jelgerlemmens/ToyTrainESP32/schematic.pdf

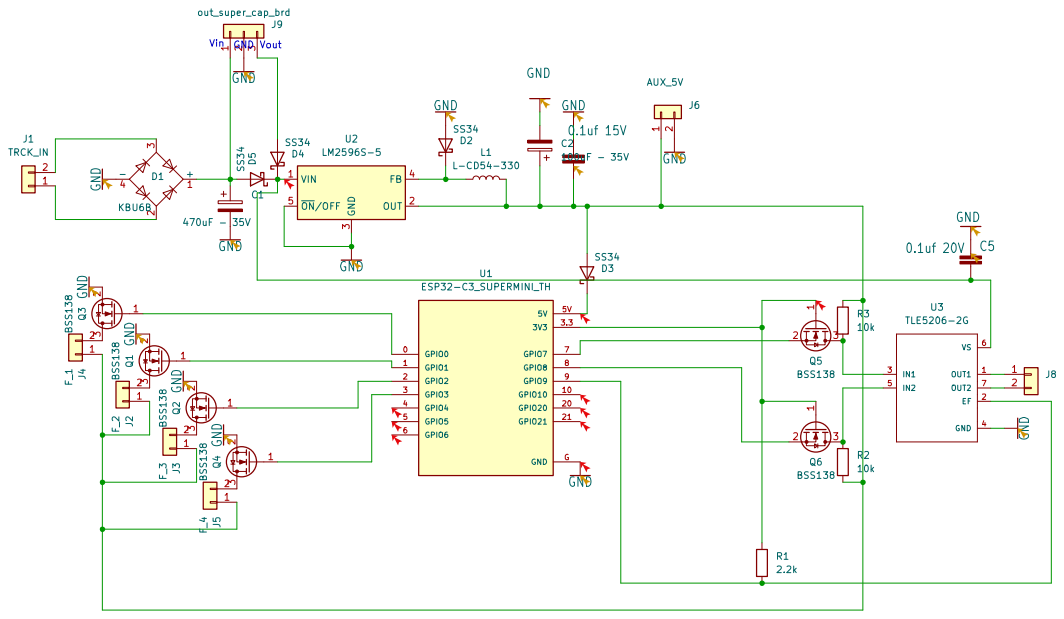
[picture p1: page 1]
