jelgerlemmens/ToyTrainESP32/kicad/decoder_esp32_rev1/decoder_esp32_rev1.kicad_pcb

## KiCad design kicad/decoder_esp32_rev1/decoder_esp32_rev1.kicad_pcb (2026-06-09)

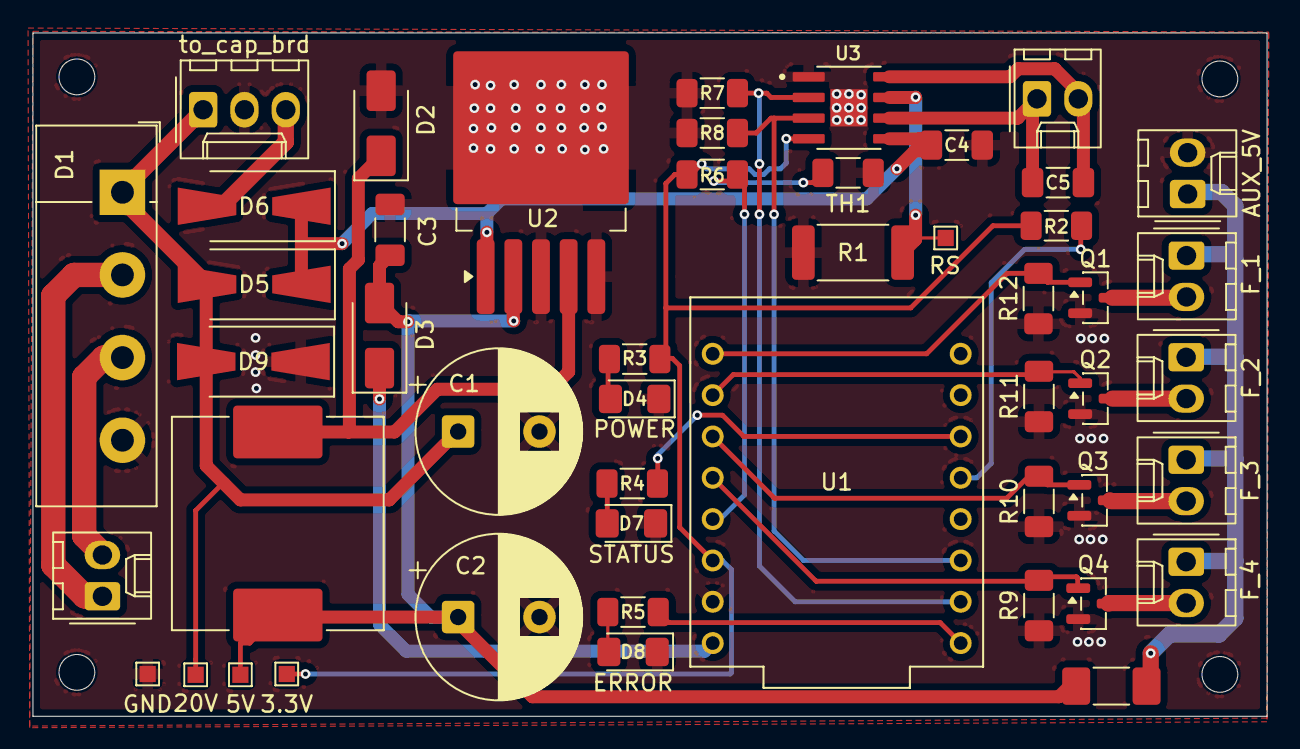
[picture p2: board decoder_esp32_rev1.kicad_pcb from above]

Board: 2 copper layers, 75.9 x 42.0 mm, 49 parts (0 on the bottom side), 31 nets.

Parts:
C1: CP_Radial_D10.0mm_P5.00mm
C2: 470uF - 35V; CP_Radial_D10.0mm_P5.00mm
C3, C4, C5: 0.1uF; C_1206_3216Metric_Pad1.33x1.80mm_HandSolder
D1: KBU6B; Diode_Bridge_Vishay_KBU
D2, D3: SS34; D_SMA
D4: POWER; D_1206_3216Metric_Pad1.42x1.75mm_HandSolder
D5, D6: S5M; D_SMA-SMB_Universal_Handsoldering
D7: STATUS; D_1206_3216Metric_Pad1.42x1.75mm_HandSolder
D8: ERROR; D_1206_3216Metric_Pad1.42x1.75mm_HandSolder
D9: smbj24a; D_SMA-SMB_Universal_Handsoldering
F1: Fuse; C_1808_4520Metric_Pad1.72x2.30mm_HandSolder
J1: TRCK_IN; Molex_KK-254_AE-6410-02A_1x02_P2.54mm_Vertical
J2: F_2; Molex_KK-254_AE-6410-02A_1x02_P2.54mm_Vertical
J3: F_3; Molex_KK-254_AE-6410-02A_1x02_P2.54mm_Vertical
J4: F_1; Molex_KK-254_AE-6410-02A_1x02_P2.54mm_Vertical
J5: F_4; Molex_KK-254_AE-6410-02A_1x02_P2.54mm_Vertical
J6: AUX_5V; Molex_KK-254_AE-6410-02A_1x02_P2.54mm_Vertical
J8: MTR_OUT; Molex_KK-254_AE-6410-02A_1x02_P2.54mm_Vertical
J9: to_cap_brd; Molex_KK-254_AE-6410-03A_1x03_P2.54mm_Vertical
L1: 68uH; L_Changjiang_FXL1340
Q1, Q2, Q3, Q4: BSS138; SOT-23
R1: 0.15 Ohm; R_2512_6332Metric_Pad1.40x3.35mm_HandSolder
R2: 2.2K; R_1206_3216Metric_Pad1.30x1.75mm_HandSolder
R3: GRN 100Ohm; R_1206_3216Metric_Pad1.30x1.75mm_HandSolder
R4: Yellow Status 150Ohm; R_1206_3216Metric_Pad1.30x1.75mm_HandSolder
R5: Red ERROR 150Ohm; R_1206_3216Metric_Pad1.30x1.75mm_HandSolder
R6: 10k; R_1206_3216Metric_Pad1.30x1.75mm_HandSolder
R7, R8, R9, R10, R11, R12: 10K pulldown; R_1206_3216Metric_Pad1.30x1.75mm_HandSolder
TH1: Thermistor_NTC; R_1206_3216Metric_Pad1.30x1.75mm_HandSolder
TP1: GND; TestPoint_Pad_1.0x1.0mm
TP2: 20V; TestPoint_Pad_1.0x1.0mm
TP3: 5V; TestPoint_Pad_1.0x1.0mm
TP4: 3.3V; TestPoint_Pad_1.0x1.0mm
TP5: RS; TestPoint_Pad_1.0x1.0mm
U1: ESP32-C3_SUPERMINI_TH; MODULE_ESP32-C3_SUPERMINI_TH
U2: LM2596S-5; TO-263-5_TabPin3
U3: TB67H450FNG_EL; SOIC127P599X175-9N

Connections:
GND: C1.2, C2.2, C3.1, C4.1, D1.4 (-), D2.2 (A), D4.1 (K), D7.1 (K), D8.1 (K), D9.1 (K), J6.2, J9.2, Q1.2 (S), Q2.2 (S), Q3.2 (S), Q4.2 (S), R1.2, R7.1, R8.2, R9.1, R10.1, R11.1, R12.1, TH1.2, TP1.1 (1_1), U1.G (GND), U2.3 (GND), U2.5 (~ON/OFF), U3.1 (GND), U3.9 (GND)
unnamed: C1.1, D1.1 (+), D5.2 (A), D9.2 (A), J9.1, TP2.1 (1_1)
unnamed: D2.1 (K), L1.1, U2.4 (FB)
unnamed: C2.1, C3.2, D3.2 (A), F1.1, L1.2, TP3.1 (1_1), U2.2 (OUT)
unnamed: D3.1 (K), U1.5V
unnamed: D4.2 (A), R3.2
unnamed: C4.2, D5.1 (K), D6.1 (K), U2.1 (VIN), U3.5 (VM)
unnamed: D6.2 (A), J9.3
unnamed: D7.2 (A), R4.2
unnamed: D8.2 (A), R5.2
unnamed: D1.2, J1.1
unnamed: D1.3, J1.2
unnamed: F1.2, J2.1, J3.1, J4.1, J5.1, J6.1
unnamed: J2.2, Q2.3 (D)
unnamed: J3.2, Q3.3 (D)
unnamed: J4.2, Q1.3 (D)
unnamed: J5.2, Q4.3 (D)
unnamed: C5.1, J8.1, U3.6 (OUT1)
unnamed: C5.2, J8.2, U3.8 (OUT2)
unnamed: Q1.1 (G), R12.2, U1.0 (GPIO0)
unnamed: Q2.1 (G), R11.2, U1.1 (GPIO1)
unnamed: Q3.1 (G), R10.2, U1.2 (GPIO2)
unnamed: Q4.1 (G), R9.2, U1.3 (GPIO3)
unnamed: R2.2, R3.1, R6.1, TP4.1 (1_1), U1.3.3 (3V3), U3.4 (VREF)
unnamed: R6.2, TH1.1, U1.4 (GPIO4)
unnamed: R5.1, U1.5 (GPIO5)
unnamed: R7.2, U1.6 (GPIO6), U3.2 (IN2)
unnamed: R8.1, U1.7 (GPIO7), U3.3 (IN1)
unnamed: R2.1, U1.9 (GPIO9)
unnamed: R4.1, U1.10 (GPIO10)
unnamed: R1.1, TP5.1 (1_1), U3.7 (RS)
