jelgerlemmens/ToyTrainESP32/(commit log)

2026-05-11 Initial ESP32-C3 WiFi decoder firmware
    - Connects to toytrains AP, registers with Spring Boot via HTTP POST
    - Receives speed/direction/lights/sound commands via UDP on port 4210
    - Applies PWM to TLE5206 IN1 (GPIO10) and IN2 (GPIO9)
    - Heartbeat every 30s with state resync from server response
    - Two PlatformIO envs: xiao_esp32c3 (COM9) and generic_esp32c3 (COM8)
    - generic env needs -DARDUINO_USB_CDC_ON_BOOT=1 for USB serial output
    - XIAO env needs DTR enabled on serial monitor to trigger CDC ready signal
    - Serial wait: while (!Serial && millis() < 3000) to hold boot output
2026-06-09 Add KiCad schematics, PCB files, libraries, and .gitignore
    Adds full rev1 hardware design (schematic, PCB, footprints, component libs,
    ODB++ export, BOM, schematic PDF) and updates firmware/platformio config.
    Excludes .pio build artifacts, KiCad auto-backups, and .history repos.
    [decoder_esp32_rev1.csv, decoder_esp32_rev1.kicad_pcb, decoder_esp32_rev1.kicad_sch]
2026-06-09 KiCad rev3: schematic/PCB layout reorganization + remove PWR_FLAG symbols
    Reordered components and wiring for better schematic overview.
    Removed #FLG01/#FLG02 PWR_FLAG symbols (cosmetic ERC cleanup).
    No netlist or component value changes.
    [decoder_esp32_rev1.kicad_pcb, decoder_esp32_rev1.kicad_sch]
2026-06-09 Fix GPIO4/GPIO5 assignment: thermistor back on GPIO4 (ADC1_CH4)
    GPIO5 has no ADC capability on ESP32-C3 — thermistor must stay on
    GPIO4 (ADC1_CH4). Swap ERROR LED to GPIO5 (digital output only).
    [decoder_esp32_rev1.kicad_pcb]
2026-06-09 KiCad sch: reposition ERROR LED circuit for readability
    Moved D8 + R5 + GND symbol to a cleaner area of the canvas.
    No connectivity or value changes.
    [decoder_esp32_rev1.kicad_sch]
2026-06-09 Firmware rewrite for TB67H450FNG motor driver
    applyMotor(): direction pin constant HIGH + PWM on the other pin.
    Never applies L,L (would trigger TB67H standby after 1.5ms).
    - Forward: IN1=H, IN2=PWM
    - Reverse: IN2=H, IN1=PWM
    - Brake: IN1=H, IN2=H (outputs pulled to GND)
    New pin defines for rev3 PCB: PIN_F1-F4 (GPIO0-3), PIN_ERROR_LED (GPIO5),
    PIN_STATUS_LED (GPIO10), PIN_THERMISTOR (GPIO4).
    STATUS_LED comes on after successful registration.
    ERROR_LED lights on registration failure or heartbeat error.
    wroom32 env (PIN_IN1=13, PIN_IN2=14 via build_flags) unaffected.
    [main.cpp]
